iwonder77/jumper-cable-rfid-interactive/docs/Jumper Cable Wall Batteries.pdf

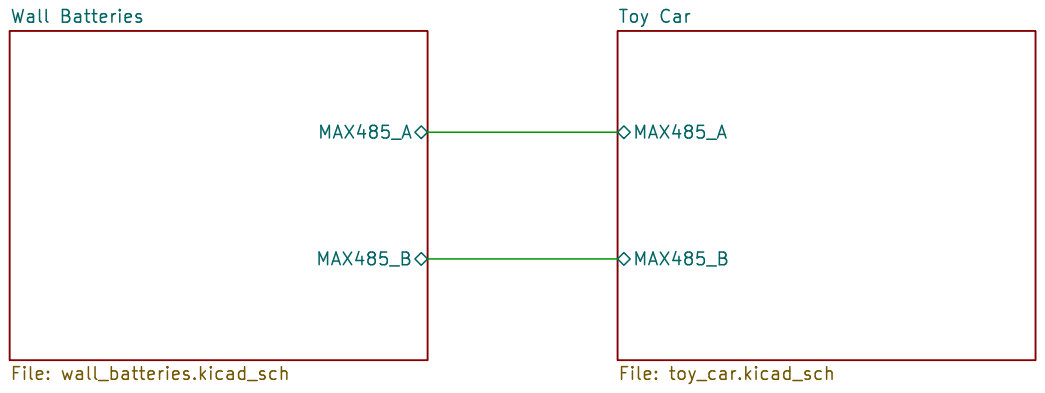
[picture p3: page 1]

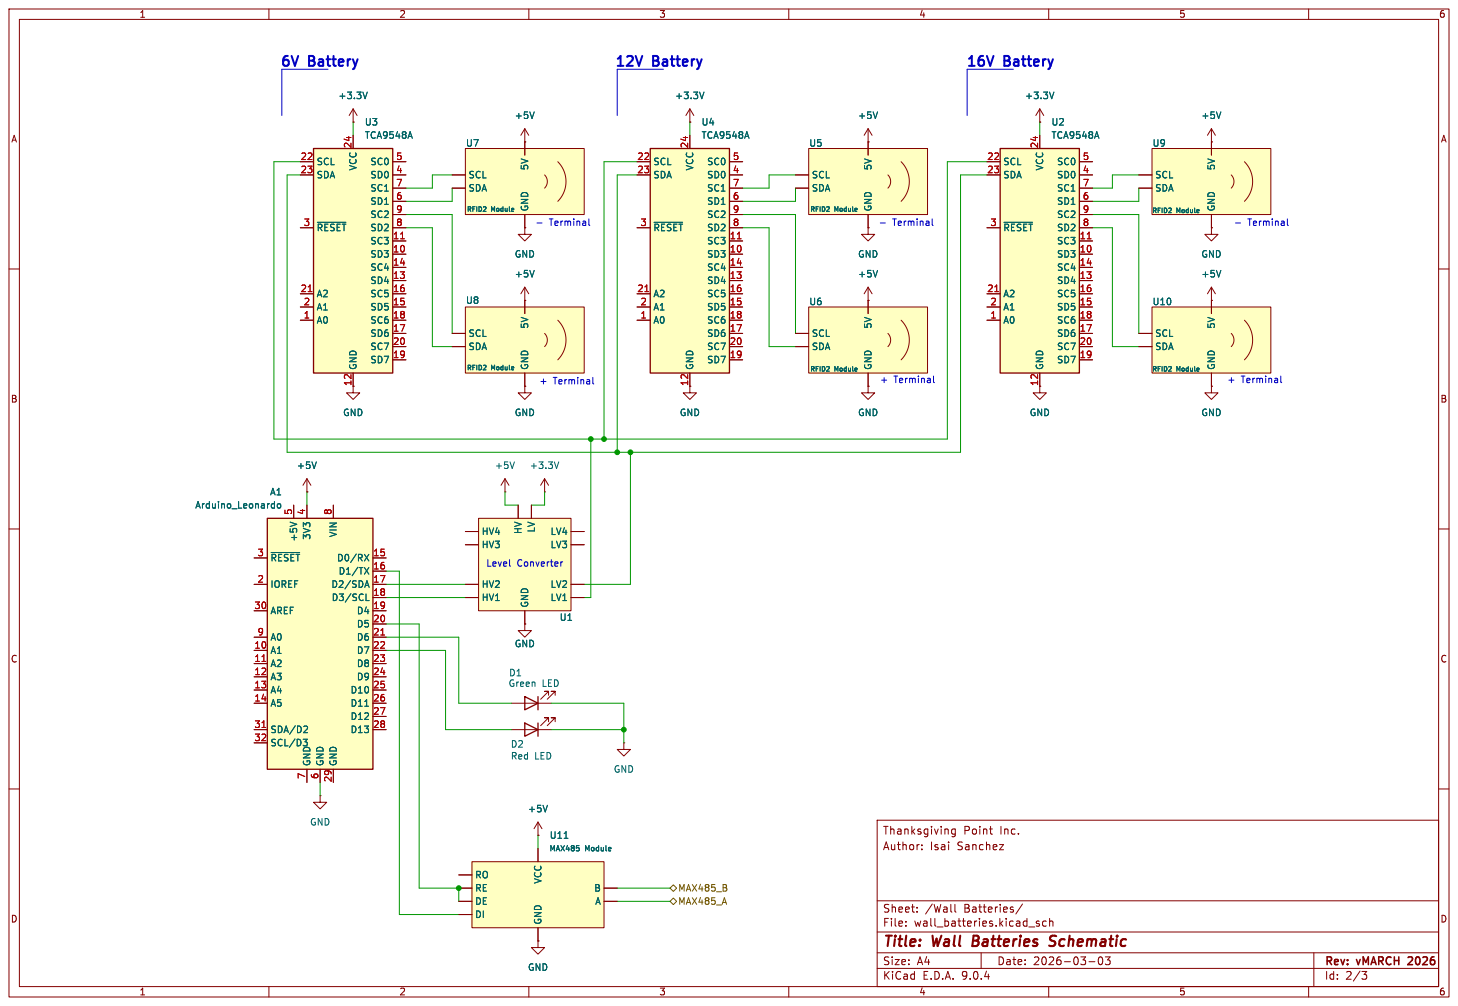
[picture p4: page 2]

+3.3V D0/RX 15 D1/TX 16 D2/SDA 17 D3/SCL 18 D4 19 D5 20 D6 21 D7 22 D8 23 D9 24 D10 25 D11 26 D12 27 D13 28 VIN 8 GND 29 GND 6 3V3 4 GND 7 +5V 5 ~{RESET} 3

IOREF 2 AREF 30 A0 9 A1 10 A2 11 A3 12 A4 13 A5 14 SDA/D2 31 SCL/D3 32 A1 Arduino_Leonardo

Id: 2/3 Title: Wall Batteries Schematic

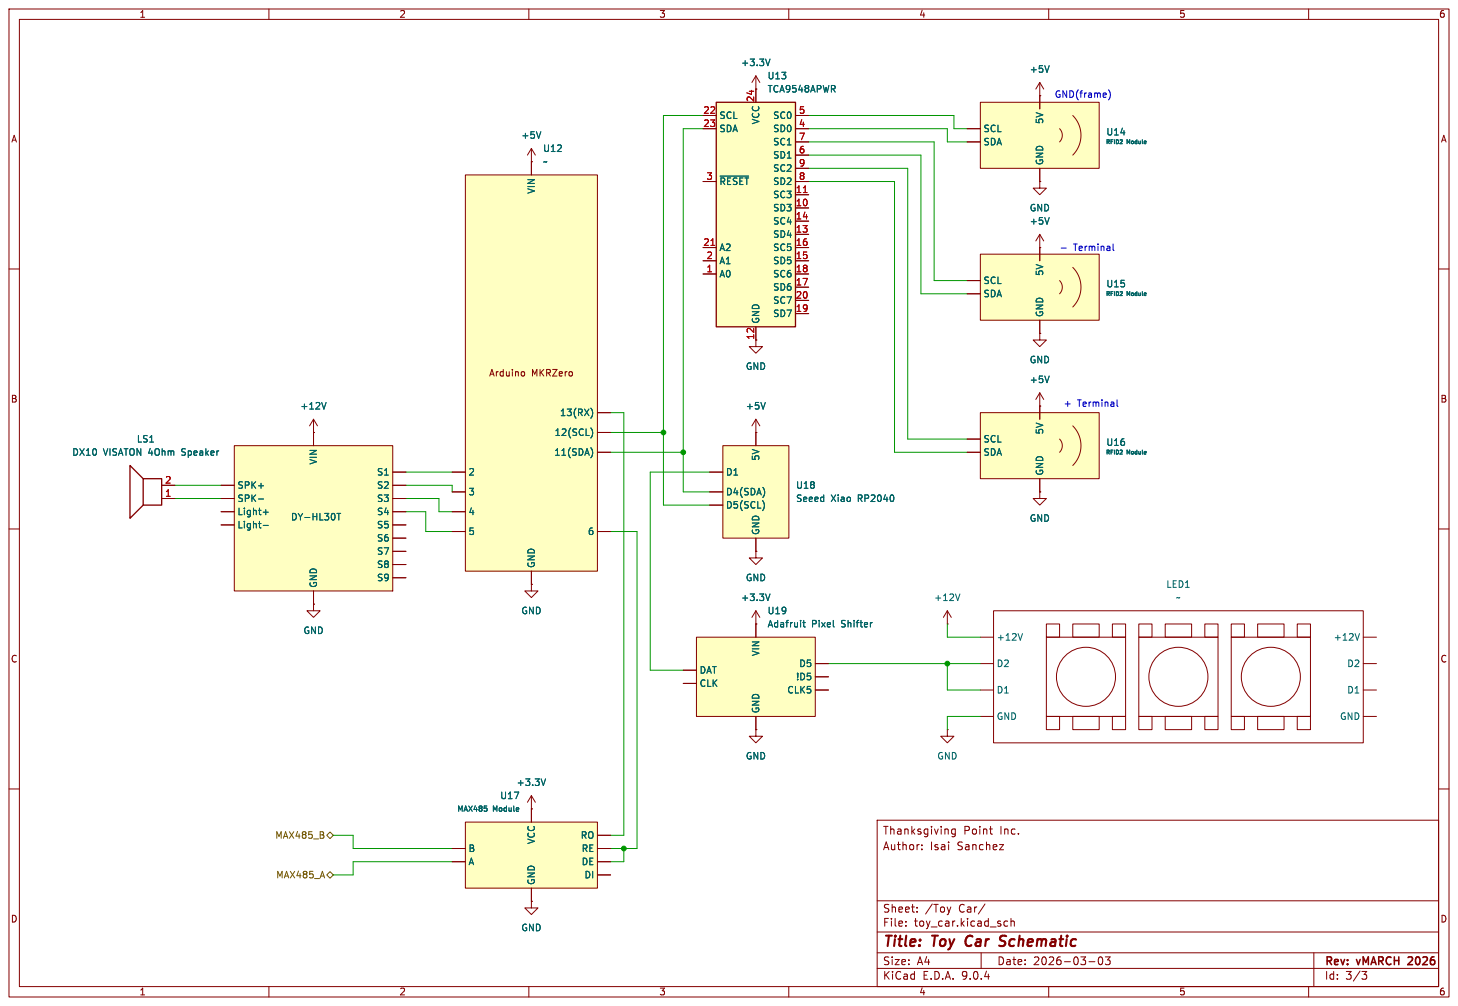
[picture p5: page 3]

Id: 3/3 Title: Toy Car Schematic
