iwonder77/jumper-cable-rfid-interactive/leonardo-tx/src/WallBatterySystem.h

#pragma once
/**
 * WallBatterySystem.h
 *
 * Coordinator for all classes and main loop
 * - hardware initialization
 * - basic LED state machine for visualizing correct polarity
 * - system health monitoring
 * - RS485 communication logic (should probably move to own class)
 */

#include <Arduino.h>
#include <MFRC522v2.h>

#include "Battery.h"
#include "Config.h"

// ----- LEDState ENUM -----
enum LEDState { LED_OFF, LED_GREEN, LED_RED };

struct BatteryState {
  bool posPresent;
  bool negPresent;
  bool posPolarity;
  bool negPolarity;

  // equality operator for easy comparison (used when checking previous vs
  // current state)
  bool operator!=(const BatteryState &other) const {
    return posPresent != other.posPresent || negPresent != other.negPresent ||
           posPolarity != other.posPolarity || negPolarity != other.negPolarity;
  }
};

class WallBatterySystem {
public:
  // constructor
  WallBatterySystem();

  // main system methods
  bool initializeSystem(MFRC522 &reader);
  void updateSystem(MFRC522 &reader);
  void processSystemLogic();

  // system status
  bool isSystemHealthy() const { return systemHealthy; };
  void printSystemStatus() const;

  // hardware setup helpers
  void initializeHardware();
  void initializeRS485();

private:
  // ----- CLASS INSTANCES -----
  Battery batteries[config::NUM_BATTERIES];
  BatteryState lastStates[config::NUM_BATTERIES];

  // ----- SYSTEM STATE -----
  LEDState currentLEDState;
  LEDState lastLEDState;
  int activeBattery;
  bool systemHealthy;

  // ----- TIMING CONTROL -----
  unsigned long lastPollTime;
  uint8_t currentPollingBattery;

  // ----- PRIVATE METHODS -----

  // battery management
  bool initializeBatteries(MFRC522 &reader);
  BatteryState getCurrentBatteryState(uint8_t batteryIndex) const;

  // communication
  void updateCommunication();
  void sendBatteryPacket(uint8_t batteryIndex, const BatteryState &state);

  // LED control
  void updateLEDs();
  LEDState determineLEDState();
  int findActiveBattery() const;
  void setLEDState(LEDState state);

  // System health
  void updateSystemHealth();
  void handleSystemFailure() const;

  // Utility
  void disableAllMuxChannels();
};
