iwonder77/jumper-cable-rfid-interactive/(commit log)

2025-08-19 added Battery and MuxController classes, cleaned up main sketch
2025-08-19 added other possible/valid pairs on the configuration correct method
    [Battery.cpp]
2025-08-20 added rfid reader i2c address to initialization of terminal readers in constructor of battery object
2025-08-20 timing of delay() function in initializeReaders and updateReaders() function was wrong, must be placed after channel switching to allow time for reader instance to read, also the reader instance is b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
    [Battery.cpp]
2025-08-20 TerminalReader objects now must be initialized with a new address variable for their rfid i2c address
2025-08-21 removed re-initialization (PCD_Init) of reader instance after every channel switch in the updateReaders method
2025-08-21 removed channel disabling before channel switching in selectChannel() method, not necessary
2025-08-21 fixed LED state issue where light was RED when only one cable present, is now OFF
2025-09-02 new initialization methods for testing MUX comm and rfid reader init, serial output of initialization centralized here in Battery class for better debugging
2025-09-02 previous initialization in setup() now handled solely by battery class
2025-09-02 all Serial.print statements changed to DEBUG_PRINT macro
2025-09-03 packet sent on every battery state change now
2025-09-03 fixed small bug on constructing packet's POS_PRESENT byte
    [WallBatterySystem.cpp]
2025-09-05 started to push the nano past its limit, plus software serial couldn't handle sending safe/reliable data, so I switched to a mega since it was the only other one at hand that uses different uart port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
2025-09-09 reduced delay when switching mux channel and reinitializing MFRC522 readers
2025-09-09 board is now leonardo
2025-09-09 default i2c pins on leonardo are 2 (SDA) and 3 (SCL) so led pins were changed
2025-09-25 new RS485 receiver class that simply takes care of hardware serial initialization, de/re pin config, and consumes incoming bytes, validates and creates packets, and hands the packets off to the handl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
2025-09-25 added logic to play sounds based on battery id and only when correct configuration of clamps is achieved
    [ToyCarSystem.cpp]
2025-09-29 added debug print statements for mux communication
2025-09-29 forgot to call Wire.begin() for I2C communication
2025-09-29 found and replaced magic number (1) used in polarity check, replaced with actual channel config variable
    [TerminalReader.cpp]
2025-09-29 added state machine for toy car terminals, as well as logic to track state transitions and play audio only when states transition
2025-10-02 added new audio file to play for any wrong configuration
    [Config.h]
2025-10-02 incorrect sound plays for present but incorrect configuration on toy car side, but not when there is an incorrect but present configuration on wall battery side
2025-10-02 wrong buzzer audio play logic was nested inside successfullConnection loop, didn't play when wall battery side was incorrect, now fixed but messy
    [ToyCarSystem.cpp, ToyCarSystem.h]
2025-10-07 changed negative and positive terminal channels and fixed magic number issue that checked for correct polarity boolean
    [Config.h, TerminalReader.cpp]
2025-10-08 added parameters for LED strip stuff
2025-10-08 added first draft logic for led strip animation, however we need a non blocking way of playing an animation when conditions are right
2025-10-08 NEW LED CLASS WOOO
2025-10-08 animation frame interval variable added and volume set back to 50 percent
2025-10-08 added new default and wrong animations
    [LEDController.cpp, LEDController.h]
2025-10-08 removed PCD_Init() call for every reader, added rfid check interval (nonblocking) but animation of LEDs is still quite slow
2025-10-15 new folder to hold rp2040 sketch for receiving i2c commands and handling FastLED animation logic
2025-10-15 new variables for i2c comm with rp2040 and commands
2025-10-15 class has been replaced with command sending class LEDCommander haha cool name huh
    [LEDCommander.cpp, LEDCommander.h, LEDController.cpp, LEDController.h]
2025-10-15 figuring out i2c logic for sending animation commands to rp2040 I am so close
2025-10-16 debugging output to ensure commands were being sent correctly using wire.endTransmission result
    [LEDCommander.cpp]
2025-10-16 I thought I already said this but this file now works for special 6V, 12V, 16V aniamtions and has debugging output
2025-10-21 6V animation improved, default animation changed to a more subtle glow, and new WRONG animation added that simply glows the strip red
    [LEDController.cpp]
2025-10-21 added wrong animation command
    [Config.h]
2025-10-21 rewrote receive command logic to include new wrong animation command
    [rp2040.ino]
2025-10-28 updated LED count
2025-10-28 added glowing wrong animation
    [LEDController.cpp]
2025-10-28 changed RS485 DE Pin to pin 6 on mkrzero and added wrong animation command
    [Config.h]
2025-10-28 added logic to send wrong animation command in wrong animation mode
    [ToyCarSystem.cpp]
2025-10-28 electron offset for 12V animation had to change sign for correct direction of wave travel on strip
    [LEDController.cpp, LEDController.h]
2025-11-04 added watchdog timer to reset when hang
    [leonardo-tx.ino]
2025-11-17 removed debug mode and added watchdog timer
2025-11-19 Refactor: replaced i2s audio logic in AudioPlayer with digital trigger-based logic (#1)
    * Audio Player class now sends HIGH signals to DY-HL30T octocoupler edition to play sounds instead of using i2s
    * changed pinout to match physical space
    ---------
    [AudioPlayer.cpp, AudioPlayer.h, Config.h, ToyCarSystem.cpp]
2025-12-12 add improved documentation to Battery class to adhere to style guide and stay consistent across repos
2025-12-12 add video link for jumper cable demo
2026-03-03 include schematic files
2026-03-03 update to show schematic files
2026-04-17 update all logic levels to work with replaced active-low DY-HV30T sound module, now sound triggering works by sending low signal
    [AudioPlayer.cpp]
